danielljeon/maze_bot/Core/Src/main.c

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
/* Includes ------------------------------------------------------------------*/
#include "main.h"

/* USER CODE BEGIN Includes */
#include "bno085_runner.h"
#include "can.h"
#include "controls.h"
#include "drive.h"
#include "h_bridge_control.h"
#include "scheduler.h"
#include "state_machine.h"
#include "vl53l4cd_runner.h"
/* USER CODE END Includes */

CAN_HandleTypeDef hcan1;

I2C_HandleTypeDef hi2c1;

SPI_HandleTypeDef hspi1;
DMA_HandleTypeDef hdma_spi1_rx;
DMA_HandleTypeDef hdma_spi1_tx;

TIM_HandleTypeDef htim2;
TIM_HandleTypeDef htim15;
DMA_HandleTypeDef hdma_tim15_ch1_up_trig_com;

void SystemClock_Config(void);
static void MX_GPIO_Init(void);
static void MX_DMA_Init(void);
static void MX_SPI1_Init(void);
static void MX_TIM2_Init(void);
static void MX_I2C1_Init(void);
static void MX_TIM15_Init(void);
static void MX_CAN1_Init(void);
/**
  * @brief  The application entry point.
  * @retval int
  */
int main(void)
{

  /* MCU Configuration--------------------------------------------------------*/

  /* Reset of all peripherals, Initializes the Flash interface and the Systick. */
  HAL_Init();

  /* Configure the system clock */
  SystemClock_Config();

  /* Initialize all configured peripherals */
  MX_GPIO_Init();
  MX_DMA_Init();
  MX_SPI1_Init();
  MX_TIM2_Init();
  MX_I2C1_Init();
  MX_TIM15_Init();
  MX_CAN1_Init();
  /* Infinite loop */
  /* USER CODE BEGIN WHILE */
  HAL_Delay(1000);

  // Initialize CAN bus.
  can_init();

  // Initialize VL53L4CD.
  vl53l4cd_init();
  vl53l4cd_start();

  HAL_NVIC_DisableIRQ(EXTI4_IRQn);

  // Initialize scheduler (required for timers).
  scheduler_init();

  // Initialize BNO085.
  bno085_reset();
  bno085_init();

  // Initialize motor driver.
  h_bridge_command_init();

  // Initialize control loops.
  control_loops_init();

  // Initialize scheduler tasks.
  void (*heading_task)(void) = heading_loop;
  void (*yaw_rate_task)(void) = yaw_rate_loop;
  void (*state_machine_task)(void) = run_state_machine;
  void (*drive_task)(void) = drive;
  void (*tof_task)(void) = vl53l4cd_process;
  scheduler_add_task(heading_task, 10);
  scheduler_add_task(yaw_rate_task, 5);
  scheduler_add_task(state_machine_task, 10);
  scheduler_add_task(drive_task, 2);
  scheduler_add_task(tof_task, 100);

  HAL_NVIC_EnableIRQ(EXTI4_IRQn);

  while (1) {
    bno085_run();
    scheduler_run();
    /* USER CODE END WHILE */

    /* USER CODE BEGIN 3 */
  }
  /* USER CODE END 3 */
}

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
