danielljeon/maze_bot/maze_bot.ioc

Mcu.UserName=STM32L432KCUx
PA0.Signal=GPIO_Output
PA1.Signal=GPIO_Output
PA10.Signal=I2C1_SDA
PA11.Signal=CAN1_RX
PA12.Signal=CAN1_TX
PA2.Signal=S_TIM15_CH1
PA3.Signal=S_TIM15_CH2
PA4.Signal=GPIO_Output
PA5.Signal=SPI1_SCK
PA6.Signal=SPI1_MISO
PA7.Signal=SPI1_MOSI
PA8.Signal=GPIO_Output
PA9.Signal=I2C1_SCL
PB0.Signal=GPXTI0
PB1.Signal=GPIO_Output
PB5.Signal=GPIO_Output
PB6.Signal=GPIO_Output
