danielljeon/maze_bot/Core/Inc/configuration.h

/*******************************************************************************
 * @file configuration.h <- TODO: DEV CONFIGURATIONS!
 * @brief High level hardcoded configuration related declarations/definitions.
 *******************************************************************************
 */

#ifndef MAZE_BOT__CONFIGURATION_H
#define MAZE_BOT__CONFIGURATION_H

/** Includes. *****************************************************************/

#include "math.h"

/** Configuration definitions. ************************************************/

// Width spacing from left side ToF to the right side ToF (mm).
#define MAZE_BOT_TOF_WIDTH_SPACING_MM 115.0f

// Angle from forward vector to the ToF view vector (rad).
#define MAZE_BOT_TOF_ANGLE_RAD 0.7853982f // 45 deg.

// Dev related features:

// Define to use direct public TOF (distance_mm) data.
#define MAZE_BOT_VL53L4CD_PUBLIC_DIRECT_VAR

#endif
