danielljeon/maze_bot/Core/Src/can.c

/*******************************************************************************
 * @file can.c
 * @brief General STM32L432KC driver abstracting STM32 HAL: CAN.
 *******************************************************************************
 */

/** Includes. *****************************************************************/

#include "can.h"
#include "../maze_bot_driver/maze_bot_can_dbc.h"

/** Private variables. ********************************************************/

// Transmit variables.
CAN_TxHeaderTypeDef tx_header;
uint8_t tx_buffer[8];
uint32_t tx_mailbox;

/** Private functions. ********************************************************/

/**
 * @brief Process CAN bus messages based on the configured message structs.
 *
 * This function iterates over the statically allocated CAN bus messages and
 * checks whether the incoming message's ID and DLC match the configuration.
 * If a match is found and a receiver handler exists, that handler is invoked.
 *
 * @param header Pointer to the CAN RX header.
 * @param data Pointer to the raw data of the CAN message.
 */
void process_can_message(CAN_RxHeaderTypeDef *header, uint8_t *data) {
  for (int i = 0; i < dbc_message_count; i++) {
    // Check if the message ID matches.
    if ((header->StdId & dbc_messages[i].id_mask) ==
        dbc_messages[i].message_id) {

      // Check if the message DLC matches, or if no check required (dlc == 0).
      if (dbc_messages[i].dlc == 0 || header->DLC == dbc_messages[i].dlc) {

        // Call the rx_handler if it exists.
        if (dbc_messages[i].rx_handler) {
          can_header_t reduced_header = {header->StdId, header->ExtId,
                                         header->IDE, header->DLC, header->RTR};
          dbc_messages[i].rx_handler(&reduced_header, data);
        }

      } else {
        // Handle ID/DLC mismatch fault.
        // can_fault(); // TODO: IMPLEMENT.
        return;
      }
    }
  }
}

/** User implementations into STM32 HAL (overwrite weak HAL functions). *******/

void HAL_CAN_RxFifo0MsgPendingCallback(CAN_HandleTypeDef *hcan) {
  CAN_RxHeaderTypeDef rx_header;
  uint8_t rx_data[8];

  // Receive the CAN message.
  if (HAL_CAN_GetRxMessage(hcan, CAN_RX_FIFO0, &rx_header, rx_data) == HAL_OK) {
    // Process the received message.
    process_can_message(&rx_header, rx_data);
  }
}

void HAL_CAN_RxFifo1MsgPendingCallback(CAN_HandleTypeDef *hcan) {
  CAN_RxHeaderTypeDef rx_header;
  uint8_t rx_data[8];

  // Receive the CAN message.
  if (HAL_CAN_GetRxMessage(hcan, CAN_RX_FIFO1, &rx_header, rx_data) == HAL_OK) {
    // Process the received message.
    process_can_message(&rx_header, rx_data);
  }
}

/** Public functions. *********************************************************/

void can_init(void) {
  // Configure CAN bus filters.
  CAN_FilterTypeDef can_filter_config;

  can_filter_config.FilterActivation = CAN_FILTER_ENABLE; // Enable the filter.
  can_filter_config.FilterBank = 0; // Assign filter to bank 0.
  can_filter_config.FilterFIFOAssignment = CAN_FILTER_FIFO0; // Use FIFO0.
  // Set filter to accept all IDs.
  can_filter_config.FilterIdHigh = 0x0000;
  can_filter_config.FilterIdLow = 0x0000;
  // Set mask to 0 so that no bits are filtered, allow all messages.
  can_filter_config.FilterMaskIdHigh = 0x0000;
  can_filter_config.FilterMaskIdLow = 0x0000;
  // Use mask mode (compare message ID with mask).
  can_filter_config.FilterMode = CAN_FILTERMODE_IDMASK;
  // Use 32-bit filter scale.
  can_filter_config.FilterScale = CAN_FILTERSCALE_32BIT;
  // Filter bank config for single CAN setup.
  can_filter_config.SlaveStartFilterBank = 14;

  // Apply filter settings to CAN1.
  HAL_CAN_ConfigFilter(&hcan1, &can_filter_config);

  // Start CAN1.
  HAL_CAN_Start(&hcan1);

  // Enable interrupts.
  HAL_CAN_ActivateNotification(&hcan1, CAN_IT_RX_FIFO0_MSG_PENDING);

  // Setup CAN general members on the transmit header.
  tx_header.IDE = CAN_ID_STD;
  // Remaining members (DLC and StdId) are configured per message on transmit.
}

HAL_StatusTypeDef can_send_message_raw32(CAN_HandleTypeDef *h_can_x,
                                         const can_message_t *msg,
                                         const uint32_t signal_values[]) {
  uint8_t data[8] = {0};

  for (int i = 0; i < msg->signal_count; ++i) {
    pack_signal_raw32(&msg->signals[i], data, signal_values[i]);
  }

  // Prepare the CAN transmit header.
  tx_header.StdId = msg->message_id;
  tx_header.IDE = CAN_ID_STD;
  tx_header.RTR = CAN_RTR_DATA;
  tx_header.DLC = msg->dlc;

  return HAL_CAN_AddTxMessage(h_can_x, &tx_header, data, &tx_mailbox);
}
