danielljeon/maze_bot/Core/Inc/bno085_runner.h

/*******************************************************************************
 * @file bno085_runner.h
 * @brief BNO085 SH2 runner: init, start reports and event handling.
 *******************************************************************************
 * @note
 * Developed using https://github.com/ceva-dsp/sh2-demo-nucleo as reference.
 *******************************************************************************
 */

#ifndef MAZE_BOT__BNO085_RUNNER_H
#define MAZE_BOT__BNO085_RUNNER_H

/** Includes. *****************************************************************/

#include "sh2.h"
#include "sh2_SensorValue.h"
#include "sh2_err.h"
#include "sh2_hal_spi.h"
#include <stdio.h>

/** Definitions. **************************************************************/

#define RAD_TO_DEG (180.0 / 3.14159265358)

/** Public types. *************************************************************/

/**
 * @brief Struct containing SH-2 sensor ID and sh2_SensorConfig_t.
 */
typedef struct {
  int sensorId;
  sh2_SensorConfig_t config;
} sensor_config_t;

/** Public variables. *********************************************************/

extern sensor_config_t sensor_config[SH2_MAX_SENSOR_ID];

extern float bno085_game_quaternion_i;
extern float bno085_game_quaternion_j;
extern float bno085_game_quaternion_k;
extern float bno085_game_quaternion_real;
extern float bno085_gyro_x;
extern float bno085_gyro_y;
extern float bno085_gyro_z;
// TODO(Maze bot): Evaluate additional sensor needs.
// extern float bno085_accel_x;
// extern float bno085_accel_y;
// extern float bno085_accel_z;
// extern float bno085_lin_accel_x;
// extern float bno085_lin_accel_y;
// extern float bno085_lin_accel_z;
// extern float bno085_gravity_x;
// extern float bno085_gravity_y;
// extern float bno085_gravity_z;

/** Public functions. *********************************************************/

/**
 * @brief Initialize BNO085 with SH2 driver.
 */
void bno085_init(void);

/**
 * @brief Reset BNO085.
 */
void bno085_reset(void);

/**
 * @brief Run sensor run cycle.
 */
void bno085_run(void);

#endif
