danielljeon/maze_bot/(commit log)

2025-10-02 Nuke STM32H753ZIT6 project
2025-10-02 Add initial STM32L432KC setup
2025-10-02 Add drivers: sh2 submodule and VL53L4CD ULD
2025-10-02 Add high level driver abstractions
2025-10-02 Add simple motor control drivers
2025-10-02 Add reference frame for controls
2025-10-02 Minor PID code cleanup
2025-10-02 Fix controls motor actuation
    [controls.c]
2025-10-02 Fix VL53L4CD driver docstrings
    [vl53l4cd_runner.h]
2025-10-02 Swap to BNO085 game quat, implement local heading
    [bno085_runner.c, bno085_runner.h, controls.c, controls.h, main.c]
2025-10-02 Fix initial hardcoded state machine playbook
    [state_machine.c]
2025-10-02 Fix playbook index disconnect
    [state_machine.c]
2025-10-07 Fix docstring file name
    [controls.c]
2025-10-24 Implement DMA TOF (WIP scheduling)
2025-10-24 Swap to TIM2 scheduler
    [scheduler.h, sh2_hal_spi.h]
2025-10-24 Zero all interrupts/DMA
2025-10-24 Add WIP simplified TOF driver
2025-10-24 Fix pinout for NUCLEO-L432KC hardware
    [drive.c, h_bridge_control.c, h_bridge_control.h, main.c, maze_bot.ioc, state_machine.c]
2025-10-25 Fix TIM1 config and h-bridge driver
    [h_bridge_control.c, h_bridge_control.h, main.c, maze_bot.ioc]
2025-10-25 Swap to public TOF data variables
    [main.c, state_machine.c, vl53l4cd_runner.c, vl53l4cd_runner.h]
2025-10-27 Move to array based TOF sensor data
2025-10-31 Add initial maze navigation code
    [configuration.h]
2025-10-31 Fix critical VL53L4CD init edge case
    [vl53l4cd_runner.c]
2025-10-31 Add configuration macros for public TOF variables
    [configuration.h]
2025-10-31 Initial heading error calculation
    [configuration.h]
2025-10-31 Updated heading error calculations
    [configuration.h]
2025-10-31 Swap to vector based heading error calculation
    [configuration.h]
2025-10-31 Clean up code
    [configuration.h]
2025-10-31 Add minor fixes to drive kinematics
    [drive.c]
2025-10-31 Rework maze nav turning
    [maze_navigation.c]
2025-10-31 Try new error calc and tune forward motion
    [maze_navigation.c]
2025-10-31 Add short initial heading fix
    [maze_navigation.c]
2025-10-31 Fix critical bug (missing break in switch case)
    [bno085_runner.c]
2025-10-31 Fix README.md BoM
2025-11-05 Clean up comments
    [configuration.h]
2025-11-23 Add initial CAN bus implementation
2025-11-23 Restructure and centralize CAN drivers
2025-11-23 Fix bad bitwise logic
    [maze_navigation.c]
2025-12-06 Fix state machine with proper state exit
    [maze_navigation.c, maze_navigation.h, state_machine.c]
2025-12-06 Fix state for linear speed
    [state_machine.c]
2025-12-06 Basic maze nav calibration
2025-12-06 Update PID controls
2025-12-06 Adjust maze nav calibrations
2025-12-06 Fix bad controls tune
    [controls.c]
